Mewtry/REPO_MYT/Documentos Técnicos/Imagens/MYT_CONTROL_PCB.png

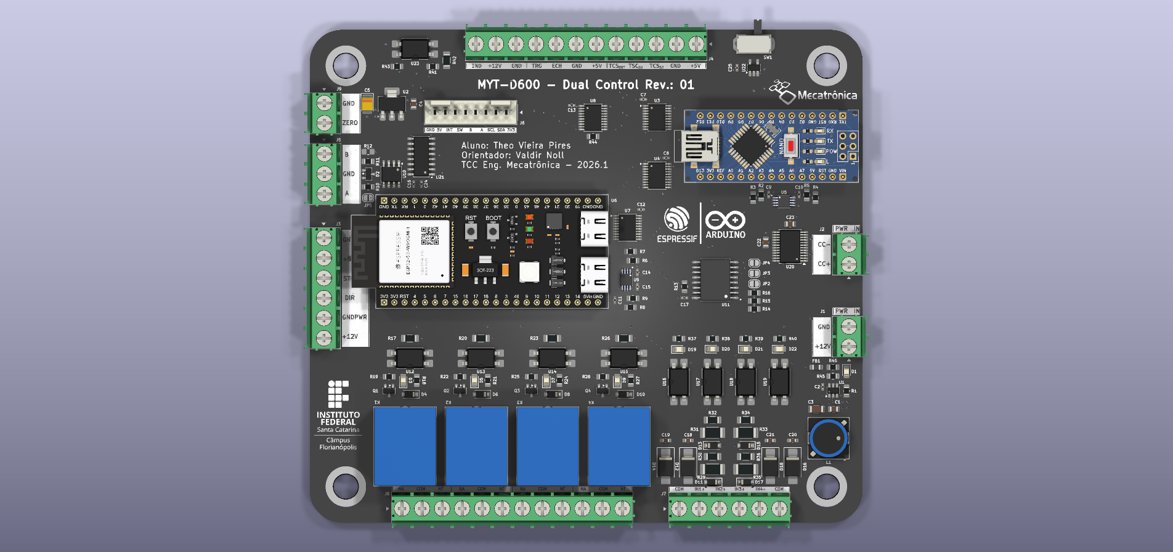
Documentos Técnicos/Imagens/MYT_CONTROL_PCB.png
