Mewtry/REPO_MYT/Documentos Técnicos/Imagens/MYT_IHM_PCB.png

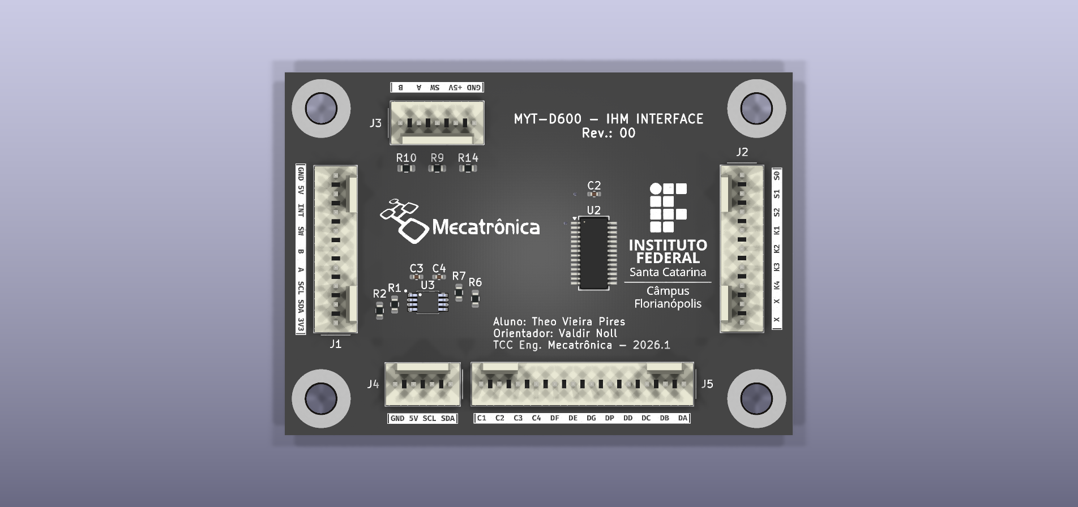
Documentos Técnicos/Imagens/MYT_IHM_PCB.png
