Mewtry/REPO_MYT/Documentos Técnicos/BOM/BOM.xlsx

Sheet: MYT_PCB
Reference | Qty | Value | PartNumber | Package | Footprint | Descrição | Datasheet
U5,U9 | 2 | PCA9517ADP | PCA9517ADP | TSSOP-8 | PCA9517ADP:SOP65P490X110-8N | Level translating I2C-bus repeater | Link (https://www.nxp.com/docs/en/data-sheet/PCA9517A.pdf)
U22 | 1 | 74LVC1G04 | 74LVC1G04 | SOT-23-5 | Package_TO_SOT_SMD:SOT-23-5_HandSoldering | Single NOT Gate, Low-Voltage CMOS | Link (https://www.ti.com/lit/ds/symlink/sn74lvc1g04.pdf)
U21 | 1 | 74HCT4053 | 74HCT4053 | SOIC-16 | Package_SO:SOIC-16_3.9x9.9mm_P1.27mm | 8-channel analog multiplexer/demultiplexer | Link (https://assets.nexperia.com/documents/data-sheet/74HC_HCT4053.pdf)
U20 | 1 | TB6612FNG | TB6612FNG | SSOP-24 | Package_SO:SSOP-24_5.3x8.2mm_P0.65mm | Driver IC for Dual DC motor, SSOP-24 | Link (https://cdn.sparkfun.com/datasheets/Robotics/TB6612FNG.pdf)
U12,U13,U14,U15,U16,U17,U18,U19,U23 | 9 | LTV-817 | LTV-817 | SMDIP-4 | Package_DIP:SMDIP-4_W9.53mm | DC Optocoupler, Vce 35V, CTR 50%, SMDIP-4 | Link (https://optoelectronics.liteon.com/upload/download/ds-70-96-0016/ltv-8x7%20series%20201610%20.pdf)
U11 | 1 | PCF8574DWR | PCF8574DWR | SOIC-16 | PCF8574DWR:SOIC127P1030X265-16N | 8-Bit I/O Expander for I2C Bus | Link (https://www.ti.com/lit/ds/symlink/pcf8574.pdf)
U10 | 1 | MAX485CSA | MAX485CSA | SOIC-8 | Package_SO:SOIC-8_3.9x4.9mm_P1.27mm | Half duplex RS-485/RS-422, 2.5 Mbps, ±15kV electro-static discharge (ESD) protection, no slew-rate, no low-power shutdown, with receiver/driver enable, 32 receiver drive capability, DIP-8 and SOIC-8 | Link (https://datasheets.maximintegrated.com/en/ds/MAX1487E-MAX491E.pdf)
U8 | 1 | SN74LVC245PW | SN74LVC245PW | TSSOP-20 | Package_SO:TSSOP-20_4.4x6.5mm_P0.65mm | 8-Bit Single-Supply Bus Transceiver With 5V tolerant input voltage and 3-State Outputs 24mA, TSSOP-20 | Link (https://www.ti.com/lit/ds/scas218x/scas218x.pdf)
U3,U4,U7 | 3 | 74HCT245PW | 74HCT245PW | TSSOP-20 | Package_SO:TSSOP-20_4.4x6.5mm_P0.65mm | Octal BUS Transceivers, 3-State outputs | Link (http://www.ti.com/lit/gpn/sn74HCT245)
U2 | 1 | AMS1117-3.3 | AMS1117-3.3 | SOT-223-3 | Package_TO_SOT_SMD:SOT-223-3_TabPin2 | 1A Low Dropout regulator, positive, 3.3V fixed output, SOT-223 | Link (http://www.advanced-monolithic.com/pdf/ds1117.pdf)
U1 | 1 | TPS563201 | TPS563201 | SOT-23-6 | Package_TO_SOT_SMD:SOT-23-6 | 3A Synchronous Step-Down Voltage Regulator, 4.5-17V Input Voltage, 0.76V to 7V Output Voltage, Eco mode, SOT-23-6 | Link (https://www.ti.com/lit/ds/symlink/tps563201.pdf)
SW1 | 1 | SW_SPDT | SW_SPDT | SW_SPDT | Button_Switch_THT:SW_Slide_SPDT_Angled_CK_OS102011MA1Q | Switch, single pole double throw
R45 | 1 | 56k | RC0805FR-0756KL | 0805 | Resistor_SMD:R_0805_2012Metric_Pad1.20x1.40mm_HandSolder | 56k 1% (1/8W) Resistor | Link (https://www.mouser.com/catalog/specsheets/YAGEO_PYu_RC_Group_51_RoHS_L_12.pdf)
R29,R31,R33,R35 | 4 | 866R | WCR2010-866R-F | 2010 | Resistor_SMD:R_2010_5025Metric_Pad1.40x2.65mm_HandSolder | 866R 1% (1/2W) Resistor | Link (https://www.mouser.com/datasheet/3/1423/1/WCR.pdf)
R17,R20,R23,R26,R30,R32,R34,R36,R42 | 9 | 390R | RCT06-390RJ LF | 1206 | Resistor_SMD:R_1206_3216Metric_Pad1.30x1.75mm_HandSolder | 390R 5% (1/4W) Resistor | Link (https://www.urt-resistors.com/products/smd/RCT-chip-resistors.pdf)
R2,R3,R4,R5,R6,R7,R8,R9,R10,R11,R13,R14,R15,R16,R19,R22,R25,R28,R41,R43,R44,R46 | 22 | 10k | RCT0510KFLF | 0805 | Resistor_SMD:R_0805_2012Metric_Pad1.20x1.40mm_HandSolder | 10k 1% (1/8W) Resistor | Link (https://www.urt-resistors.com/products/smd/RCT-chip-resistors.pdf)
R1,R18,R21,R24,R27,R37,R38,R39,R40 | 9 | 2k7 | 0805J0272T5E | 0805 | Resistor_SMD:R_0805_2012Metric_Pad1.20x1.40mm_HandSolder | 2k7 5% (1/8W) Resistor | Link (https://www.royalohm.com/assets/pdf/products/smd/1.pdf)
Q1,Q2,Q3,Q4 | 4 | BSS138 | BSS138 | SOT-23 | Package_TO_SOT_SMD:SOT-23 | 50V Vds, 0.22A Id, N-Channel MOSFET, SOT-23 | Link (https://www.onsemi.com/pub/Collateral/BSS138-D.PDF)
L1 | 1 | 3,3uH | SLF10165T-3R3N5R8-3PF | TDK_SLF10165 | Inductor_SMD:L_TDK_SLF10165 | 3.3uH 30% 5.8A Inductor | Link (https://product.tdk.com/en/system/files/dam/doc/product/inductor/inductor/smd/catalog/inductor_commercial_power_slf10165_en.pdf)
K1,K2,K3,K4 | 4 | Relé | SRD-12VDC-SL-C | Relay From C | Relay_THT:Relay_SPDT_SANYOU_SRD_Series_Form_C | Sanyo SRD relay, Single Pole Miniature Power Relay, | Link (http://www.sanyourelay.ca/public/products/pdf/SRD.pdf)
J6 | 1 |  | KK-254_AE-6410-09A | KK-254 | Connector_Molex:Molex_KK-254_AE-6410-09A_1x09_P2.54mm_Vertical | IHM Interface Conector | Link (https://www.molex.com/en-us/products/part-detail/22292091?display=pdf)
J5 | 1 |  |  | Terminal Block P5.0 | TerminalBlock_Phoenix:TerminalBlock_Phoenix_PT-1,5-3-5.0-H_1x03_P5.00mm_Horizontal | RS485
J4,J8 | 2 |  |  | Terminal Block P5.0 | TerminalBlock_Phoenix:TerminalBlock_Phoenix_PT-1,5-12-5.0-H_1x12_P5.00mm_Horizontal | Sensores Esteira, GP OUT
J3,J7 | 2 |  |  | Terminal Block P5.0 | TerminalBlock_Phoenix:TerminalBlock_Phoenix_PT-1,5-6-5.0-H_1x06_P5.00mm_Horizontal | Motor Magazine, GP IN
J1,J2,J9 | 3 |  |  | Terminal Block P5.0 | TerminalBlock_Phoenix:TerminalBlock_Phoenix_PT-1,5-2-5.0-H_1x02_P5.00mm_Horizontal | Vin, Motor Esteira, Zero Magazine
D12,D14,D16,D18 | 4 | SMBJ8.5A | SMBJ8.5A | SMB(DO-214AA) | Diode_SMD:D_SMB_Handsoldering | 600W unidirectional Transient Voltage Suppressor, 8.5Vr, SMB(DO-214AA) | Link (https://www.littelfuse.com/assetdocs/tvs-diodes-smbj-series-datasheet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)
D4,D6,D8,D10,D11,D13,D15,D17 | 8 | 1N4148W | 1N4148W | SOD-123 | Diode_SMD:D_SOD-123 | 75V 0.15A Fast Switching Diode, SOD-123 | Link (https://www.vishay.com/docs/86356/1n4148w.pdf)
D2 | 1 | SM712 | SM712 | SOT-23 | Package_TO_SOT_SMD:SOT-23 | 7V/12V, 600W Asymmetrical TVS Diode Array, SOT-23 | Link (https://www.littelfuse.com/~/media/electronics/datasheets/tvs_diode_arrays/littelfuse_tvs_diode_array_sm712_datasheet.pdf.pdf)
D1,D3,D5,D7,D9,D19,D20,D21,D22 | 9 | LED | 150080RS75000 | 0805 | LED_SMD:LED_0805_2012Metric_Pad1.15x1.40mm_HandSolder | LED RED 160 mcd | Link (https://www.we-online.com/components/products/datasheet/150080RS75000.pdf)
C18,C19,C20,C21 | 4 | 100nF / 50V | CC0603KRX7R9BB104 | 0603 | Capacitor_SMD:C_0603_1608Metric_Pad1.08x0.95mm_HandSolder | 100nF 25V 10% X7R Ceramic Capacitor | Link (https://br.mouser.com/datasheet/3/508/1/UPY_GPHC_X7R_6_3V_TO_250V.pdf)
C5 | 1 | 100uF / 10V | TAJB107M010SNJ | Case B / 1210 | Capacitor_Tantalum_SMD:CP_EIA-3528-21_Kemet-B_HandSolder | 100uF 10V 10% Tantalum Capacitor | Link (https://datasheets.kyocera-avx.com/TAJ.pdf)
C3 | 1 | 47uF / 16V | CL31A476MPHNNNE | 1206 | Capacitor_SMD:C_1206_3216Metric | 47uF 16V 20% X5R Ceramic Capacitor | Link (https://datasheet.lcsc.com/lcsc/2304140030_Samsung-Electro-Mechanics-CL31A476MPHNNNE_C96123.pdf)
C2,C6,C7,C8,C9,C10,C11,C12,C13,C14,C15,C16,C17,C24,C25 | 15 | 100nF / 25V | CL10B104KA8NNNC | 0402 | Capacitor_SMD:C_0402_1005Metric_Pad0.74x0.62mm_HandSolder | 100nF 25V 10% X7R Ceramic Capacitor | Link (https://weblib.samsungsem.com/mlcc/mlcc-ec-data-sheet.do?partNumber=CL10B104KA8NNN)
C1,C4,C22,C23 | 4 | 10uF / 25V | CL21A106KAYNNNE | 0805 | Capacitor_SMD:C_0805_2012Metric | 10uF 25V 10% X5R Ceramic Capacitor | Link (https://www.digikey.com.br/en/products/detail/samsung-electro-mechanics/CL21A106KOQNNNE/3886754)
Total |  |  |  |  |  |  | 34

Sheet: MYT_IHM_PCB
Reference | Qty | Value | PartNumber | Package | Footprint | Descrição | Datasheet
C2,C3,C4 | 3 | 100nF | CL05B104KO5NNNC | 0402 | Capacitor_SMD:C_0402_1005Metric_Pad0.74x0.62mm_HandSolder | 100nF 16V 10% X7R Ceramic Capacitor | Link (https://www.lcsc.com/datasheet/lcsc_datasheet_2304140030_Samsung-Electro-Mechanics-CL05B104KO5NNNC_C1525.pdf)
J1,J2 | 2 |  | AE-6410-09A | KK-254 | Connector_Molex:Molex_KK-254_AE-6410-09A_1x09_P2.54mm_Vertical | IHM Interface Conector,Teclado Matricial Conector | Link (https://www.molex.com/en-us/products/part-detail/22292091?display=pdf)
J3 | 1 | Encoder | AE-6410-05A | KK-254 | Connector_Molex:Molex_KK-254_AE-6410-05A_1x05_P2.54mm_Vertical | Encoder Conector | Link (https://www.molex.com/en-us/products/part-detail/22292051?display=pdf)
J4 | 1 | LCD I2C | AE-6410-04A | KK-254 | Connector_Molex:Molex_KK-254_AE-6410-04A_1x04_P2.54mm_Vertical | LDC I2C Conector | Link (https://www.molex.com/en-us/products/part-detail/22292041?display=pdf)
J5 | 1 | CC56-12EWA | AE-6410-12A | KK-254 | Connector_Molex:Molex_KK-254_AE-6410-12A_1x12_P2.54mm_Vertical | Display 7 SEG 4 Digitos DP Conector | Link (https://www.molex.com/en-us/products/part-detail/22272121?display=pdf)
R1,R2,R6,R7,R9,R10,R14 | 7 | 10k | 0603WAF1002T5E | 0603 | Resistor_SMD:R_0603_1608Metric | 10k 1% (1/8W) Resistor | Link (https://www.royalohm.com/assets/pdf/products/smd/1.pdf)
U2 | 1 | HT16K33 | HT16K33 | SSOP-28 | Package_SO:SSOP-28_3.9x9.9mm_P0.635mm | RAM Mapping 16*8 LED Controller Driver with keyscan | Link (https://cdn-shop.adafruit.com/datasheets/ht16K33v110.pdf)
U3 | 1 | PCA9517ADP | PCA9517ADP | TSSOP-8 | PCA9517ADP:SOP65P490X110-8N | Level translating I2C-bus repeater | Link (https://www.nxp.com/docs/en/data-sheet/PCA9517A.pdf)
Total |  |  |  |  |  |  | 8
