Mewtry/REPO_MYT/Documentos Técnicos/Diagramas/MYT_IHM_PCB.pdf

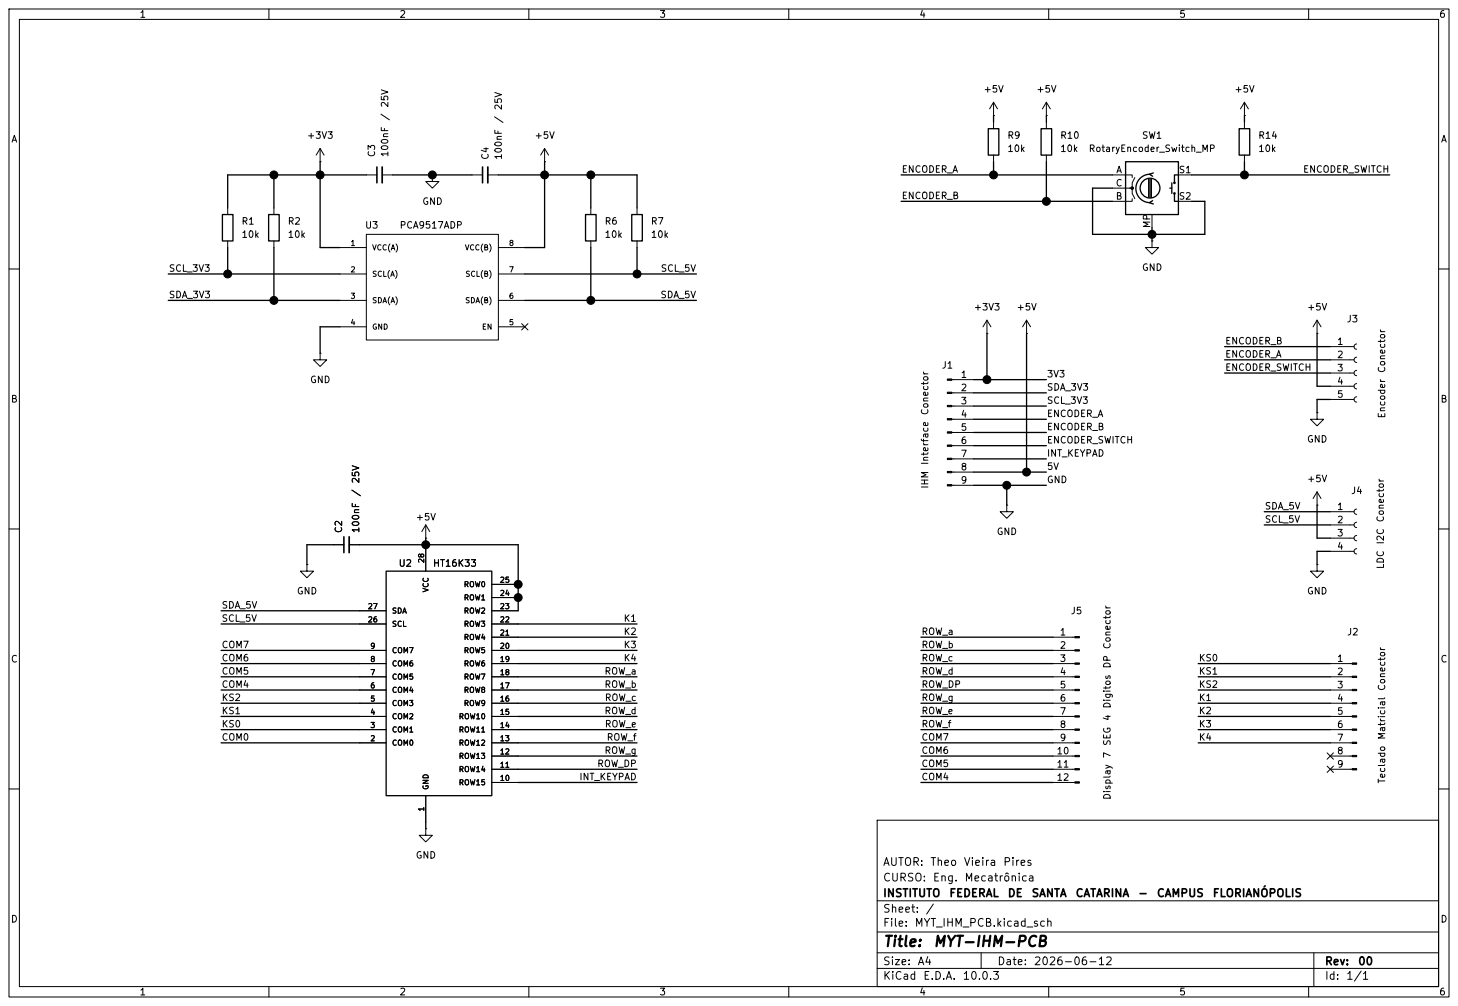
[picture p8: page 1]

CURSO: Eng. Mecatrônica
INSTITUTO FEDERAL DE SANTA CATARINA - CAMPUS FLORIANÓPOLIS
Sheet: /
File: MYT_IHM_PCB.kicad_sch
Title: MYT-IHM-PCB

Size: A4 | Rev: 00
KiCad E.D.A. 10.0.3 | Id: 1/1
