Mewtry/REPO_MYT/Documentos Técnicos/Diagramas/MYT_PCB.pdf

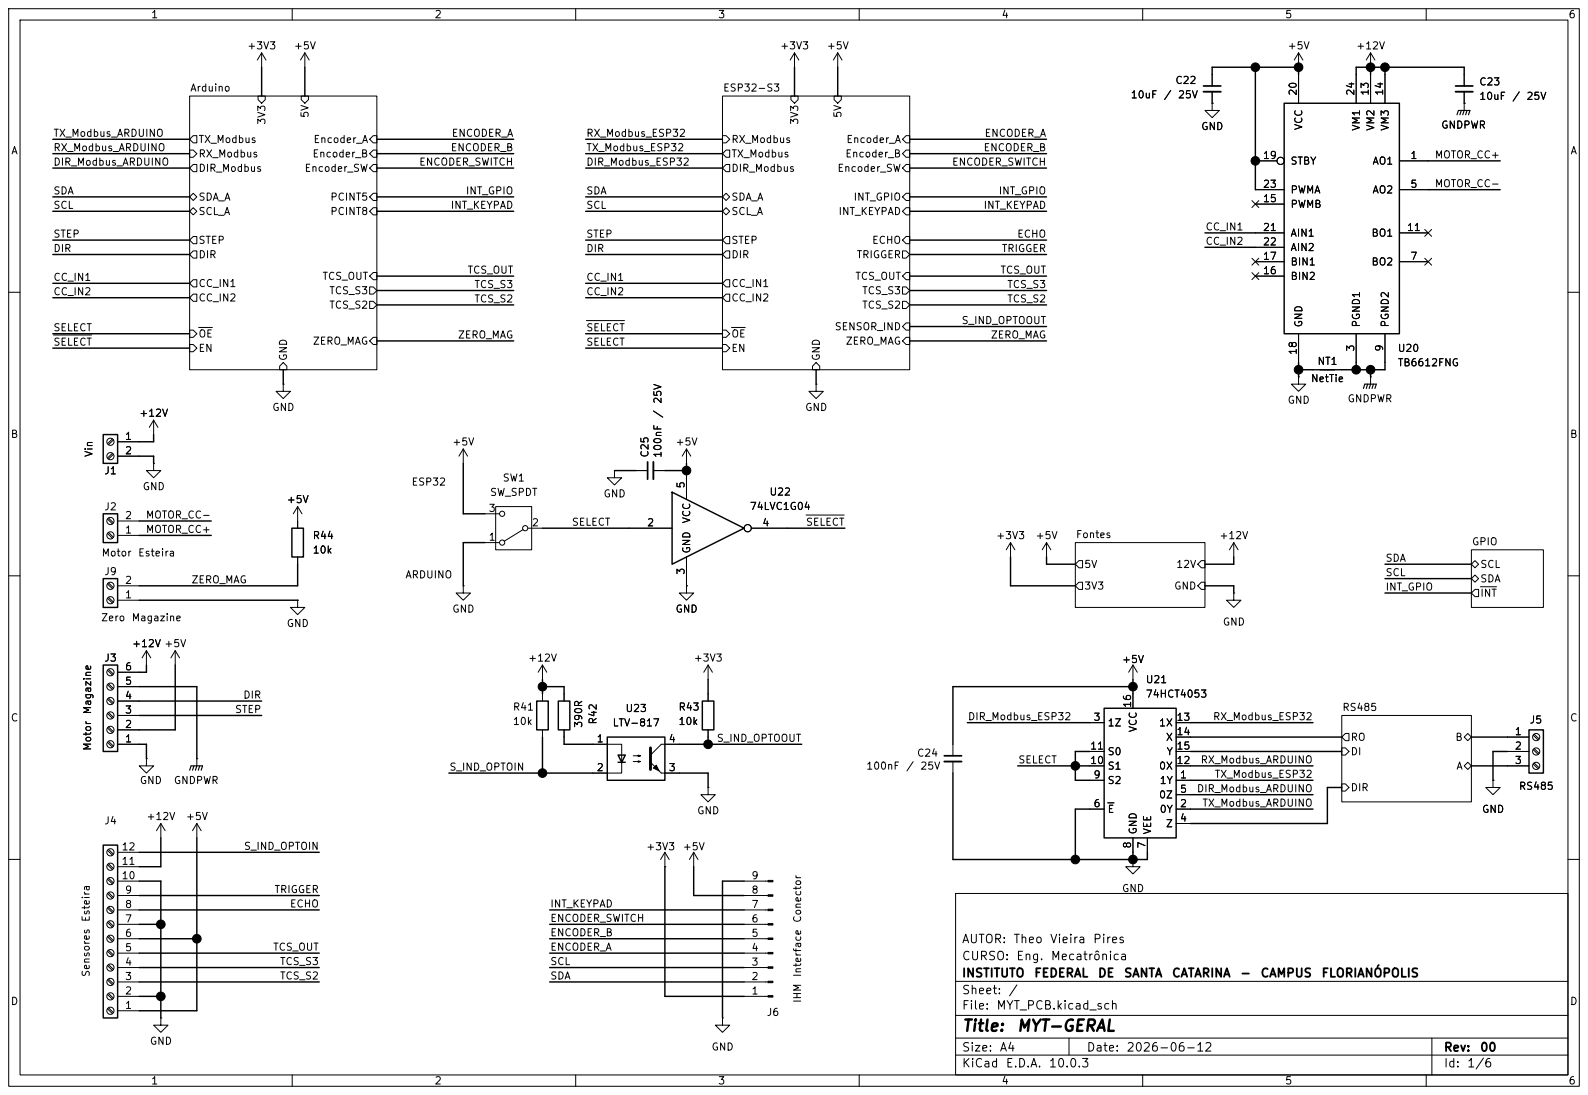
[picture p9: page 1]

4 4
3 3

AUTOR: Theo Vieira Pires
CURSO: Eng. Mecatrônica
INSTITUTO FEDERAL DE SANTA CATARINA - CAMPUS FLORIANÓPOLIS
Sheet: /
File: MYT_PCB.kicad_sch
Title: MYT-GERAL

Size: A4 | Rev: 00
KiCad E.D.A. 10.0.3 | Id: 1/6

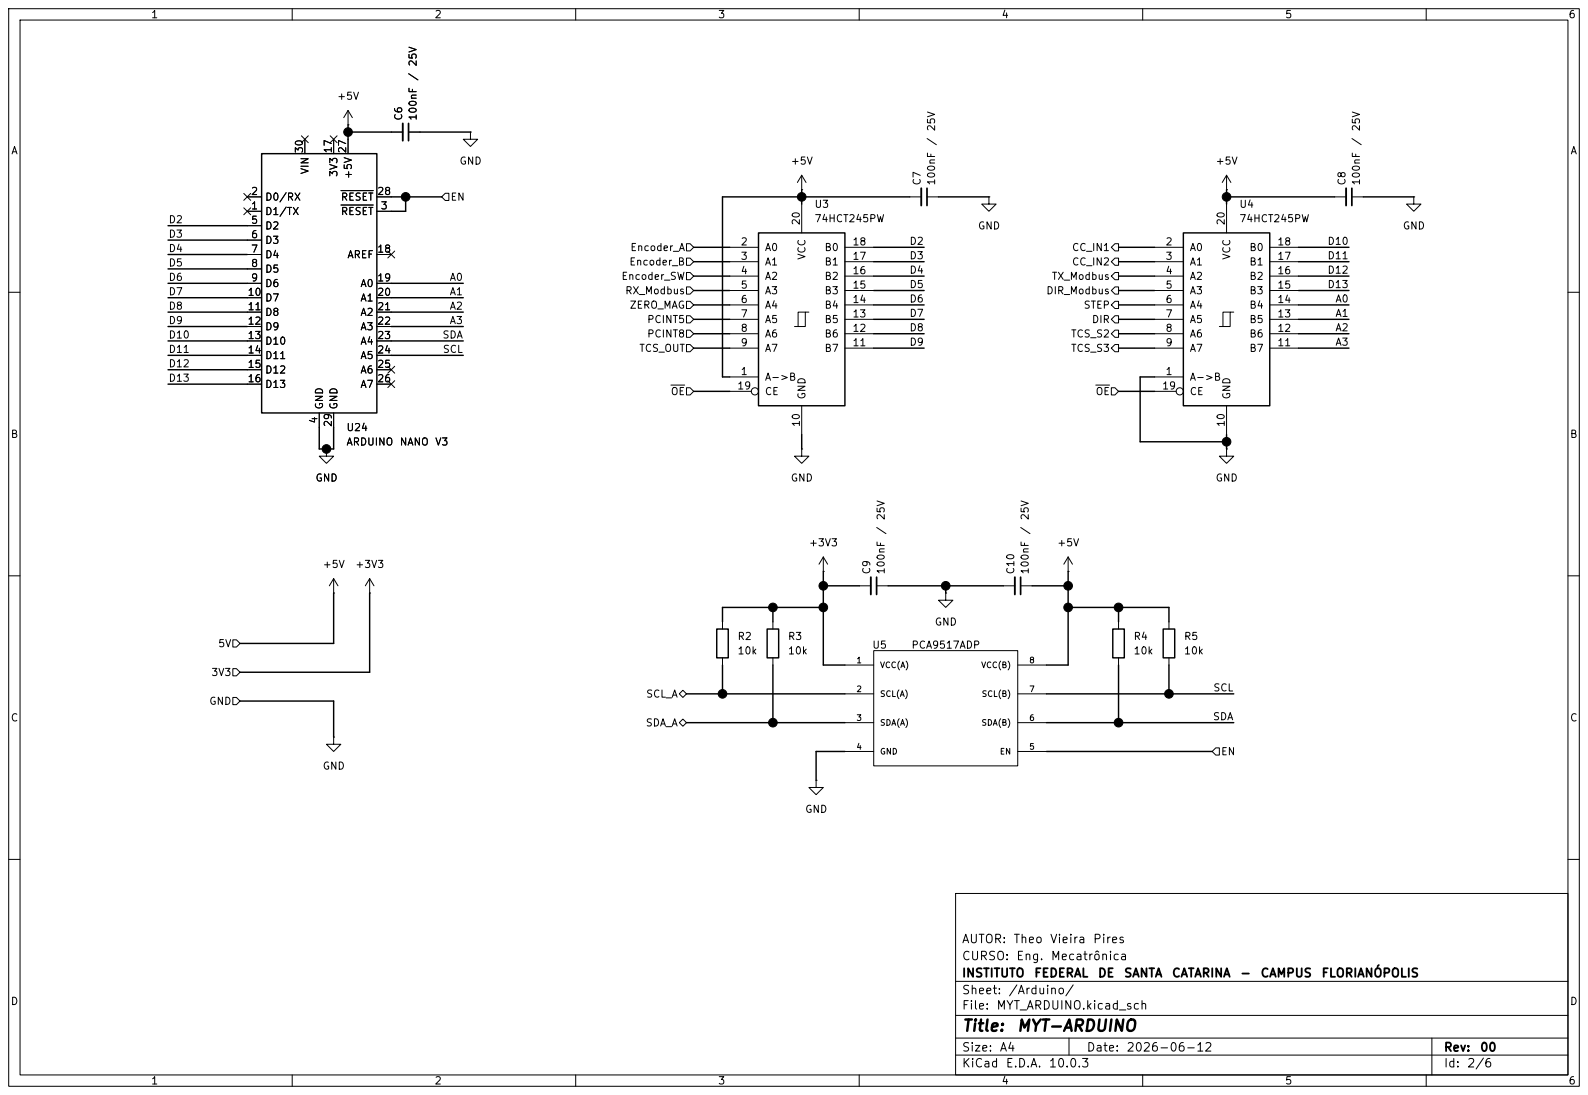
[picture p10: page 2]

AUTOR: Theo Vieira Pires +5V C10 100nF / 25V C9100nF / 25V GND

CURSO: Eng. Mecatrônica
INSTITUTO FEDERAL DE SANTA CATARINA - CAMPUS FLORIANÓPOLIS
Sheet: /Arduino/
File: MYT_ARDUINO.kicad_sch
Title: MYT-ARDUINO

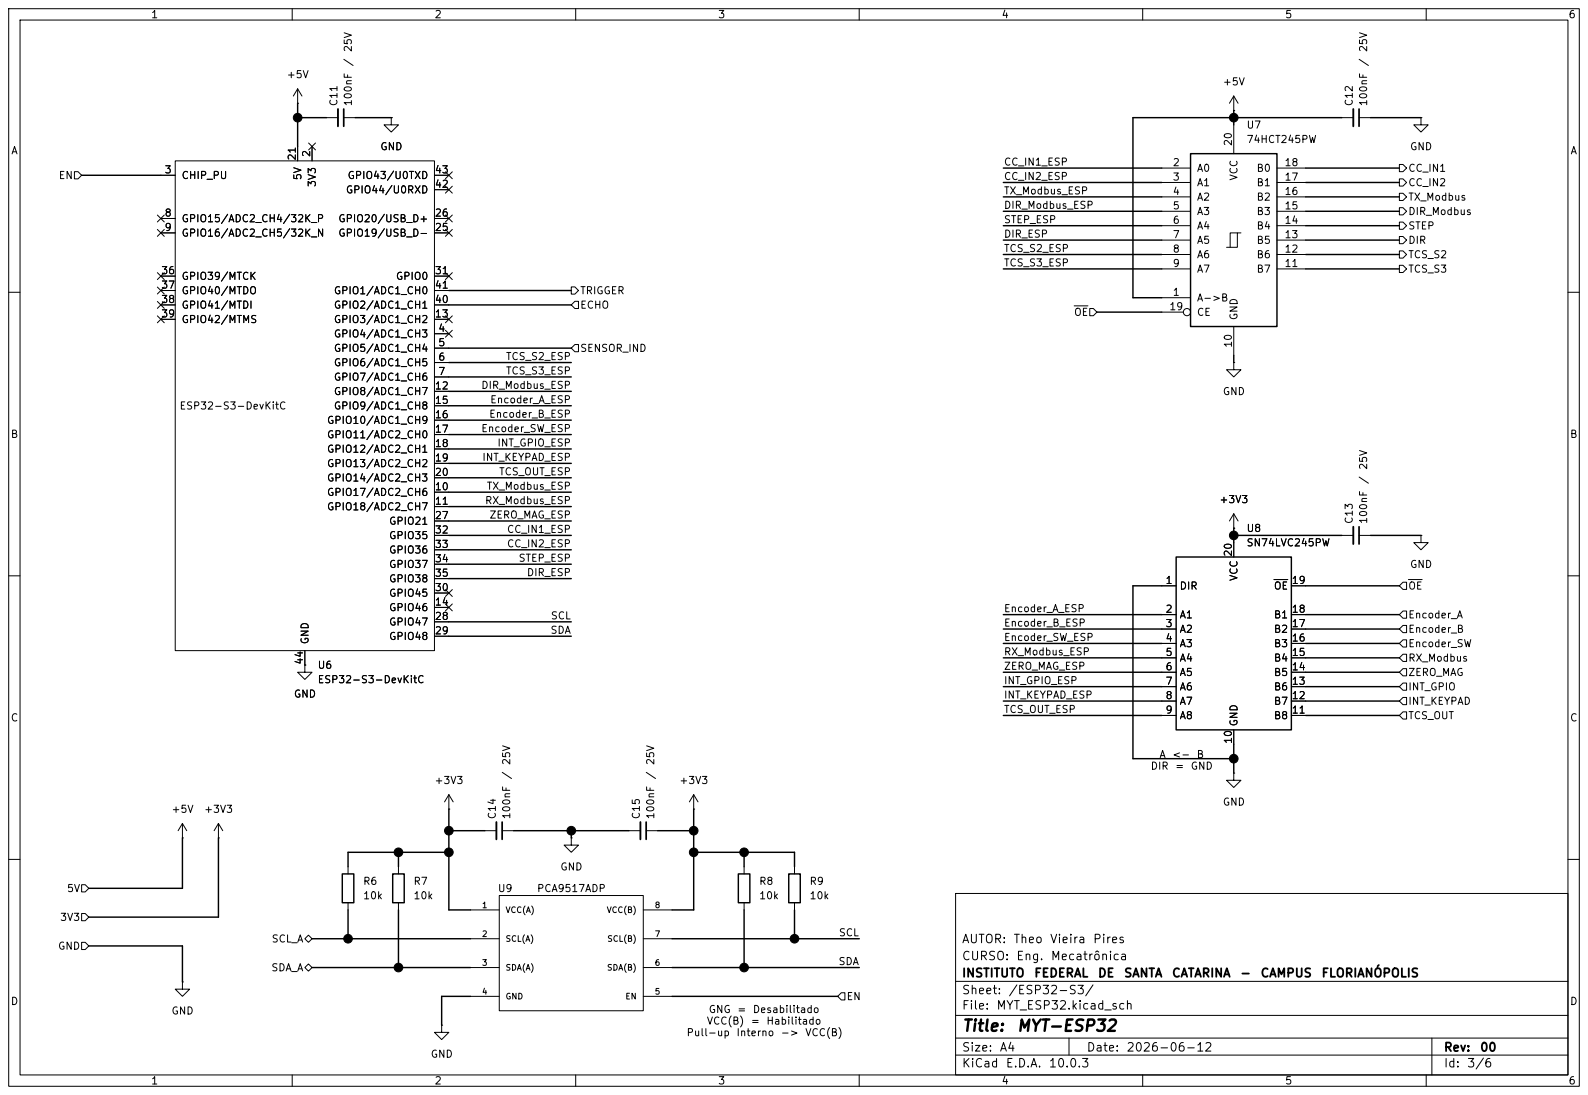
[picture p11: page 3]

AUTOR: Theo Vieira Pires C11 100nF / 25V GND

CURSO: Eng. Mecatrônica
INSTITUTO FEDERAL DE SANTA CATARINA - CAMPUS FLORIANÓPOLIS
Sheet: /ESP32-S3/
File: MYT_ESP32.kicad_sch
Title: MYT-ESP32

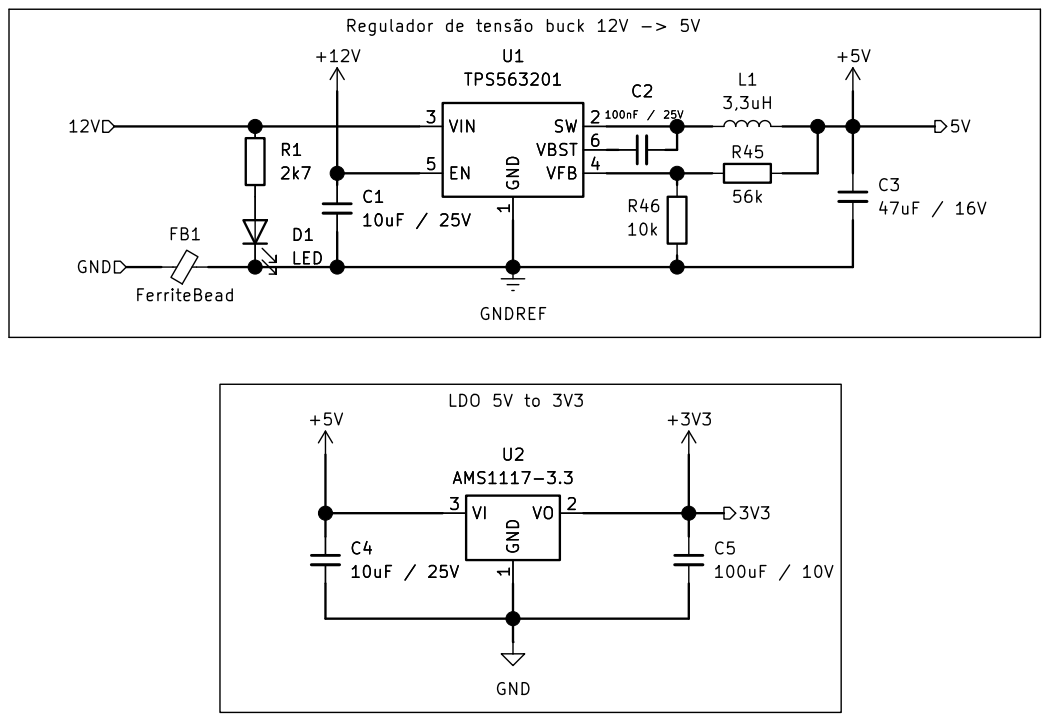
[picture p12: page 4]

LDO 5V to 3V3 Regulador de tensão buck 12V -> 5V C1

AUTOR: Theo Vieira Pires GND

CURSO: Eng. Mecatrônica
INSTITUTO FEDERAL DE SANTA CATARINA - CAMPUS FLORIANÓPOLIS
Sheet: /Fontes/
File: MYT_FONTES.kicad_sch
Title: MYT-FONTE

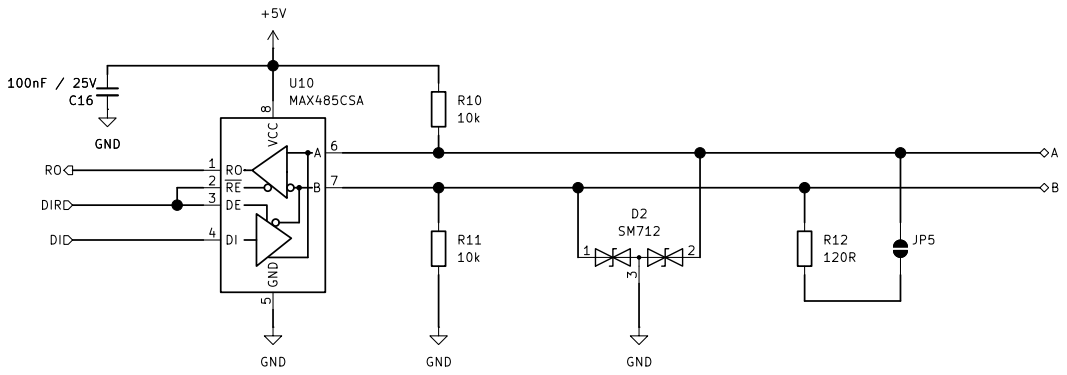
[picture p13: page 5]

AUTOR: Theo Vieira Pires GND

CURSO: Eng. Mecatrônica
INSTITUTO FEDERAL DE SANTA CATARINA - CAMPUS FLORIANÓPOLIS
Sheet: /RS485/
File: MYT_RS485.kicad_sch
Title: MYT-RS485

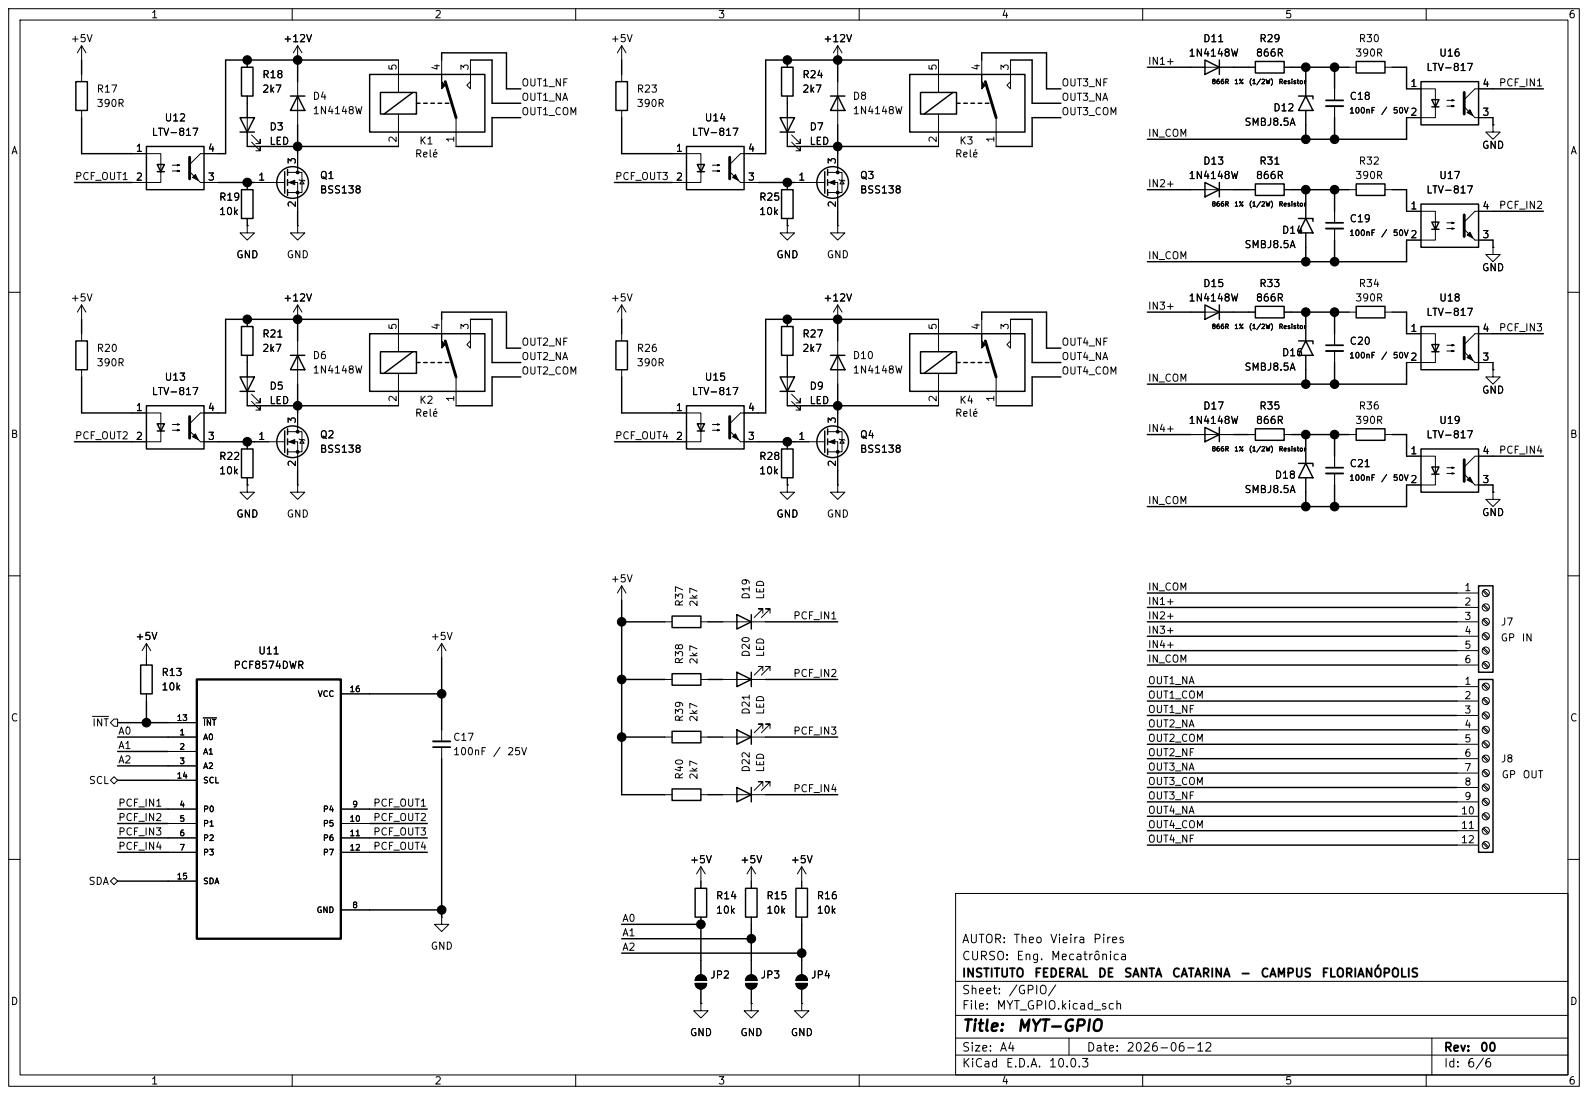
[picture p14: page 6]

AUTOR: Theo Vieira Pires
CURSO: Eng. Mecatrônica
INSTITUTO FEDERAL DE SANTA CATARINA - CAMPUS FLORIANÓPOLIS
Sheet: /GPIO/
File: MYT_GPIO.kicad_sch
Title: MYT-GPIO
